sparkfun/SparkFun_IoT_RedBoard-ESP32-P4/docs/docs/Resources.md

# Resources

For more information about the SparkFun IoT RedBoard ESP32-P4's, take a look at the following resources:

* [Datasheet](/ref/esp32-p4_datasheet_en.pdf) (ESP32-P4)
* [GitHub Repository](https://github.com/sparkfun/SparkFun_IoT_RedBoard-ESP32-P4)

**SparkFun IoT RedBoard ESP32-P4 & ESP32-C5 (WiFi/BLE)**

* [Schematic](/ref/SparkFun_IoT_RedBoard-ESP32-P4_WiFi_BLE.pdf)
* [KiCad Files](/ref/SparkFun_IoT_RedBoard-ESP32-P4_WiFi_BLE.zip)
* [Datasheet](/ref/esp32-c5-wroom-1_wroom-1u_datasheet_en.pdf) (ESP32-C5 WROOM)

**SparkFun IoT RedBoard ESP32-P4 - PoE**

* [Schematic](/ref/SparkFun_IoT_RedBoard-ESP32-P4_PoE.pdf)
* [KiCad Files](/ref/SparkFun_IoT_RedBoard-ESP32-P4_PoE.zip)
