sparkfun/SparkFun_IoT_RedBoard-ESP32-P4/Hardware/PoE/Production/ordering_instructions.txt

Ordering Instructions:
Panel dimensions: 389.58 x 131.24 mm.
Controlled Impedance: JLC04161H-7628
Material: TG135
Solder Mask: Red
Silkscreen Color: White
Layers: 4
Finish: Lead-Free HASL
Thickness: 1.6mm
Outer Copper Weight: 1oz
Inner Copper Weight: 0.5oz
Minimum track width: 0.12mm (4.80mil)
Minimum via drill: 0.30mm (11.81mil)
No Clean Process
