sparkfun/SparkFun_IoT_RedBoard-ESP32-P4/docs/static/ref/SparkFun_IoT_RedBoard-ESP32-P4_PoE.pdf

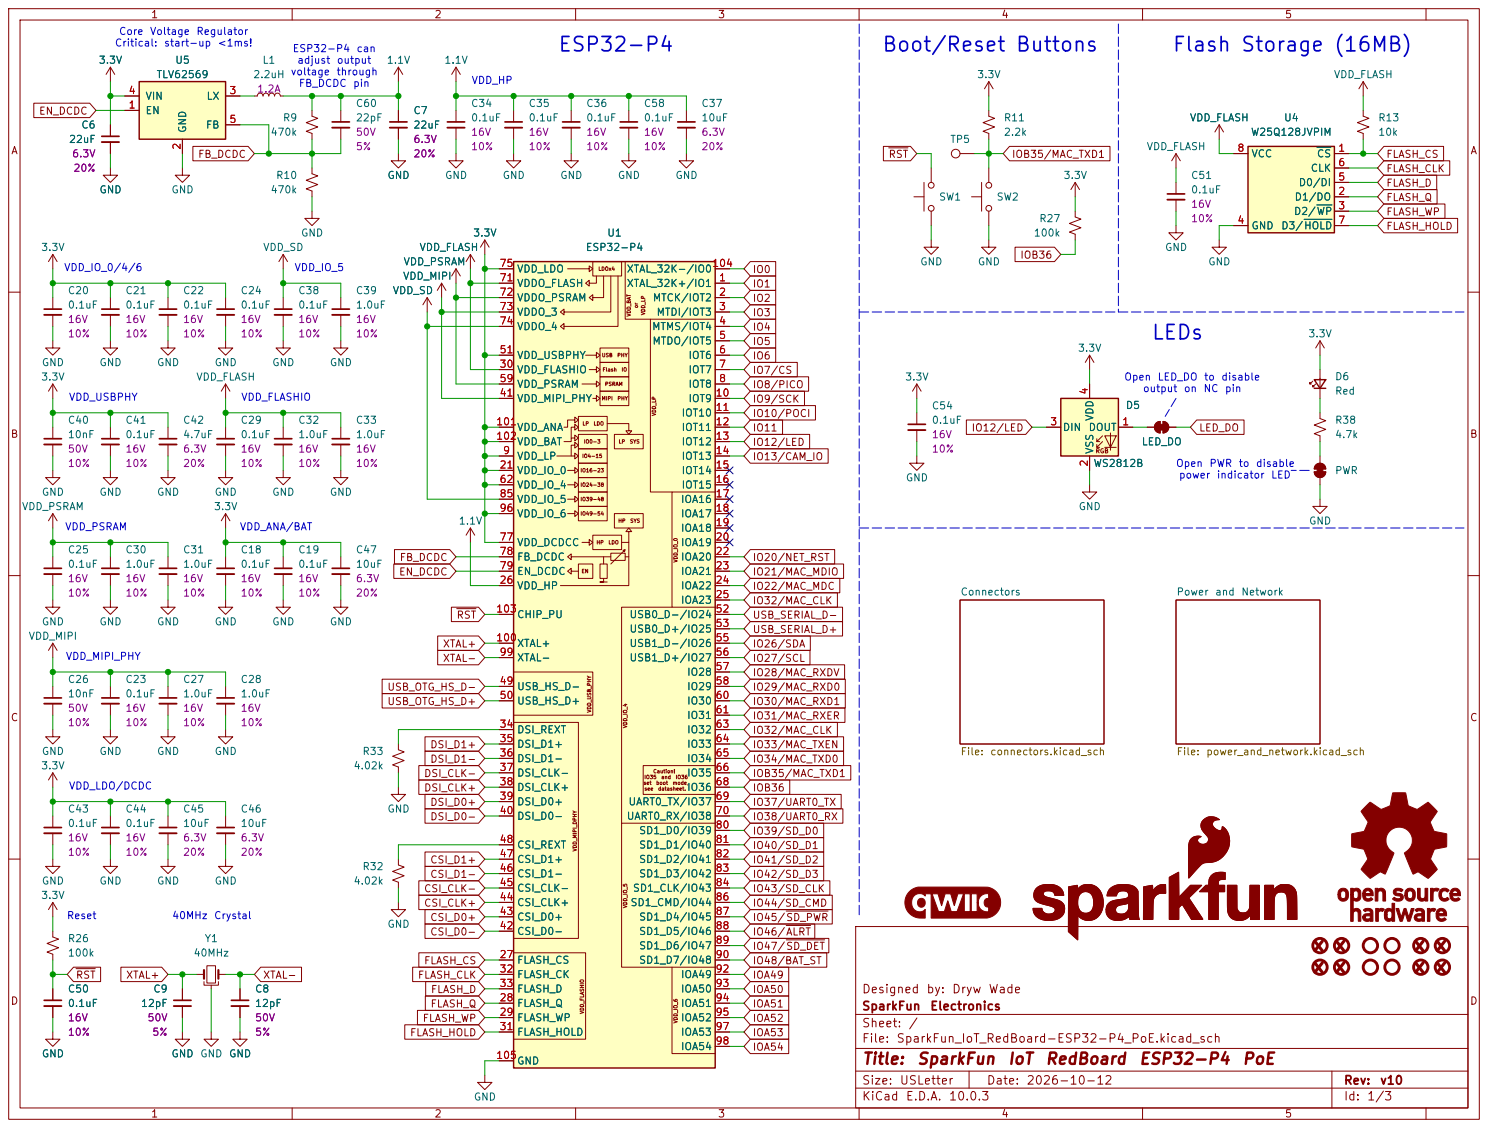
[picture p3: page 1]

Core Voltage Regulator Critical: start-up <1ms! VDD_USBPHY
TLV62569 GND

VDD_LDO 75 | XTAL_32K-/IO0104

VDDO_PSRAM 72

VDDO_4 74

Open LED_DO to disable output on NC pin

Open PWR to disable power indicator LED

Caution! IO35 and | IO35 66 IO35 66 IO36 IO36 68 UART0_TX/IO37 69 UART0_RX/IO38 70 IO36 68 UART0_TX/IO37 69 UART0_RX/IO38 70

Designed by: Dryw Wade
SparkFun Electronics
Sheet: /
File: SparkFun_IoT_RedBoard-ESP32-P4_PoE.kicad_sch
Title: SparkFun IoT RedBoard ESP32-P4 PoE

Size: USLetter | Rev: v10
KiCad E.D.A. 10.0.3 | Id: 1/3

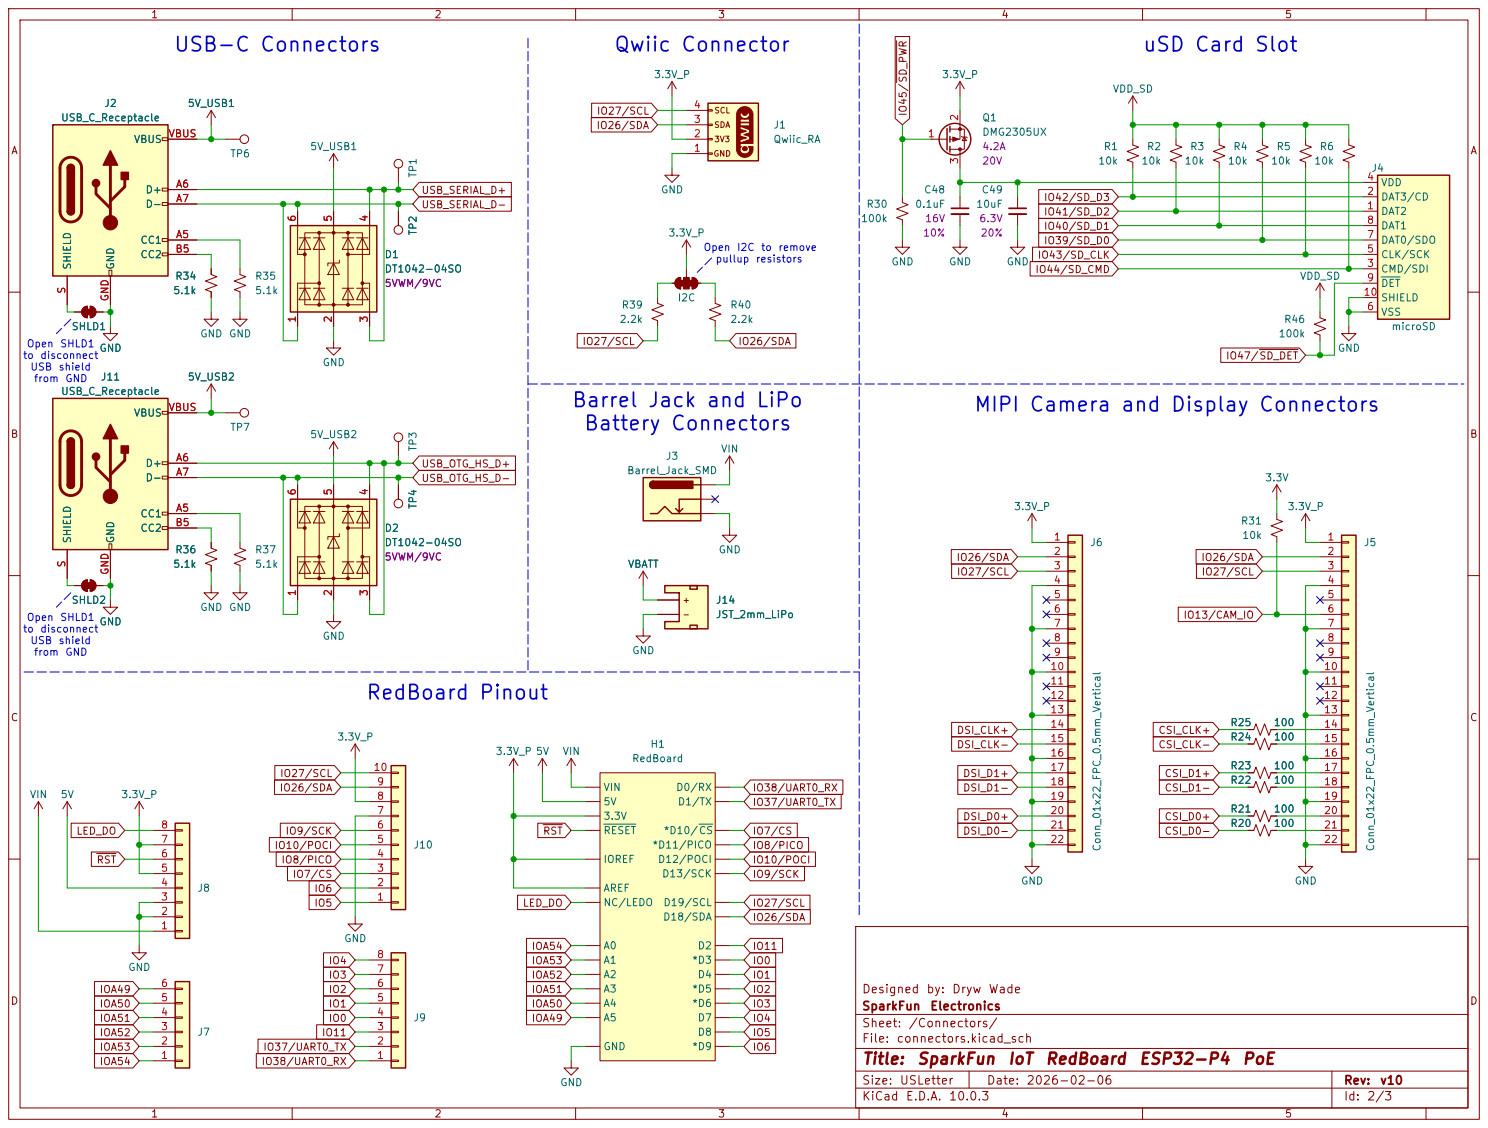
[picture p4: page 2]

VDD 4 CLK/SCK 5 VSS 6 DAT0/SDO 7 DAT1 8 DET 9

SHIELD 10

Open SHLD1
to disconnect USB shield

Barrel Jack and LiPo
Battery Connectors
VBATT VIN

IO0 Open SHLD1

Designed by: Dryw Wade
SparkFun Electronics
Sheet: /Connectors/
File: connectors.kicad_sch
Title: SparkFun IoT RedBoard ESP32-P4 PoE

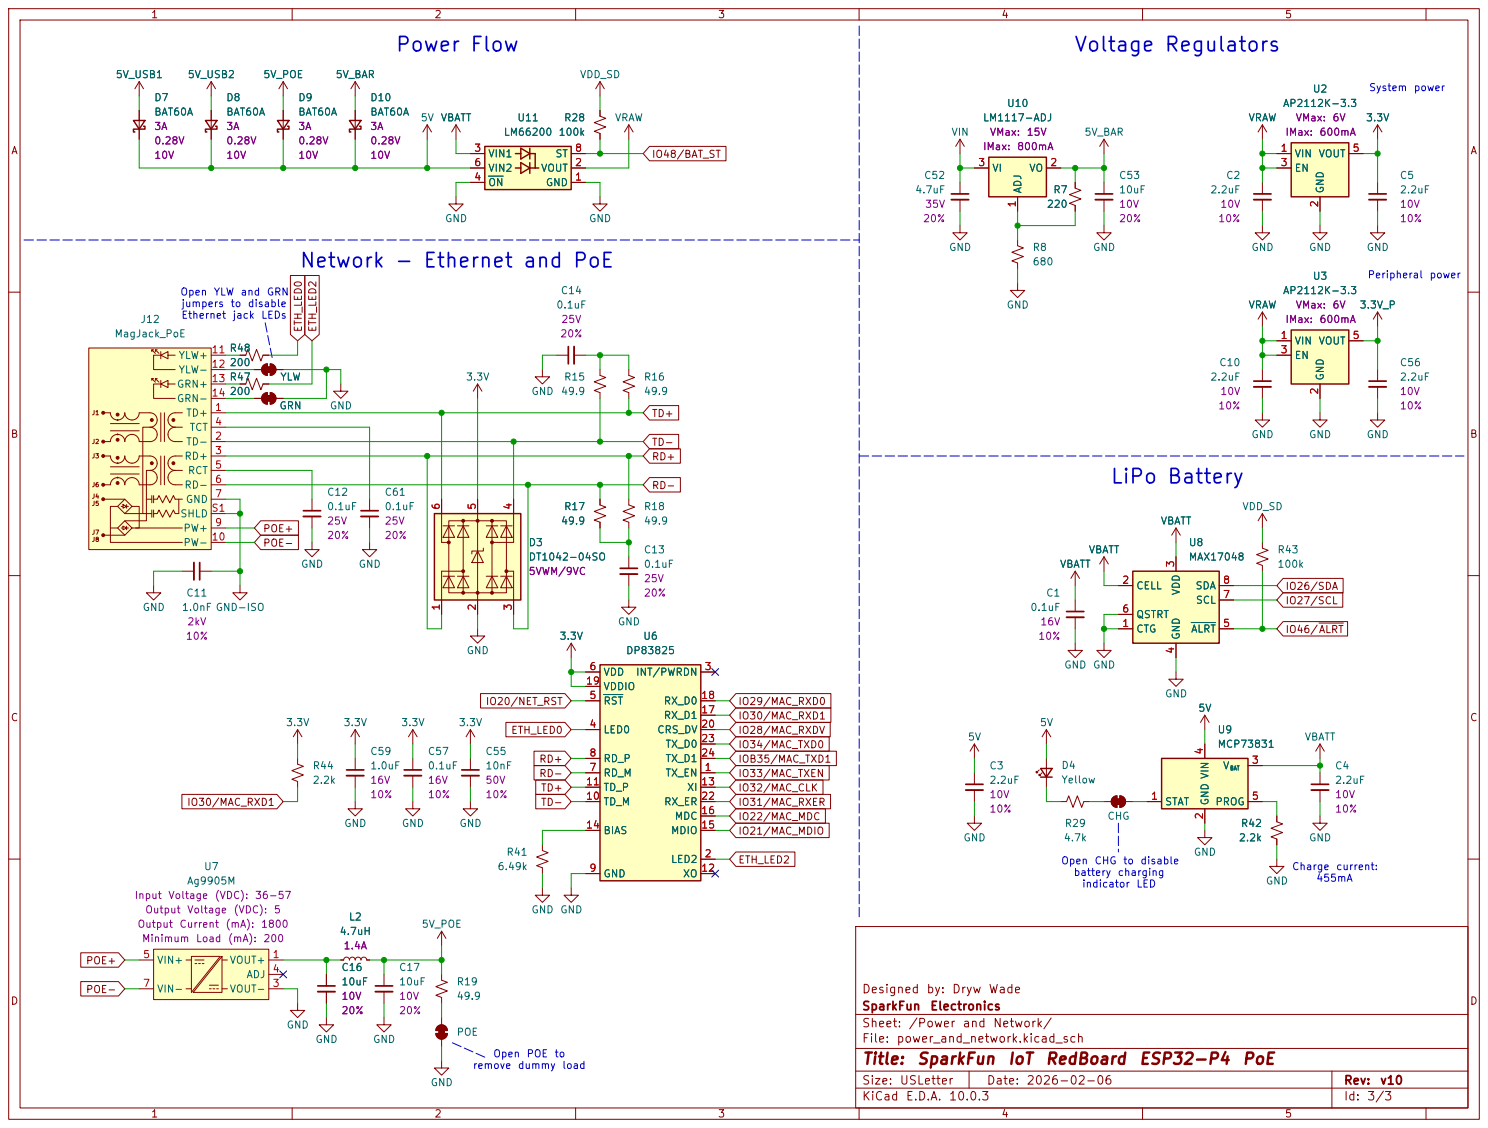
[picture p5: page 3]

indicator LED Voltage Regulators
LM1117-ADJ VMax: 15V
VIN
IMax: 800mA ADJ 1

Network - Ethernet and PoE

Peripheral power Open POE to

Open YLW and GRN

Designed by: Dryw Wade
SparkFun Electronics
Sheet: /Power and Network/
File: power_and_network.kicad_sch
Title: SparkFun IoT RedBoard ESP32-P4 PoE
