sparkfun/SparkFun_IoT_RedBoard-ESP32-P4/docs/static/ref/SparkFun_IoT_RedBoard-ESP32-P4_WiFi_BLE.pdf

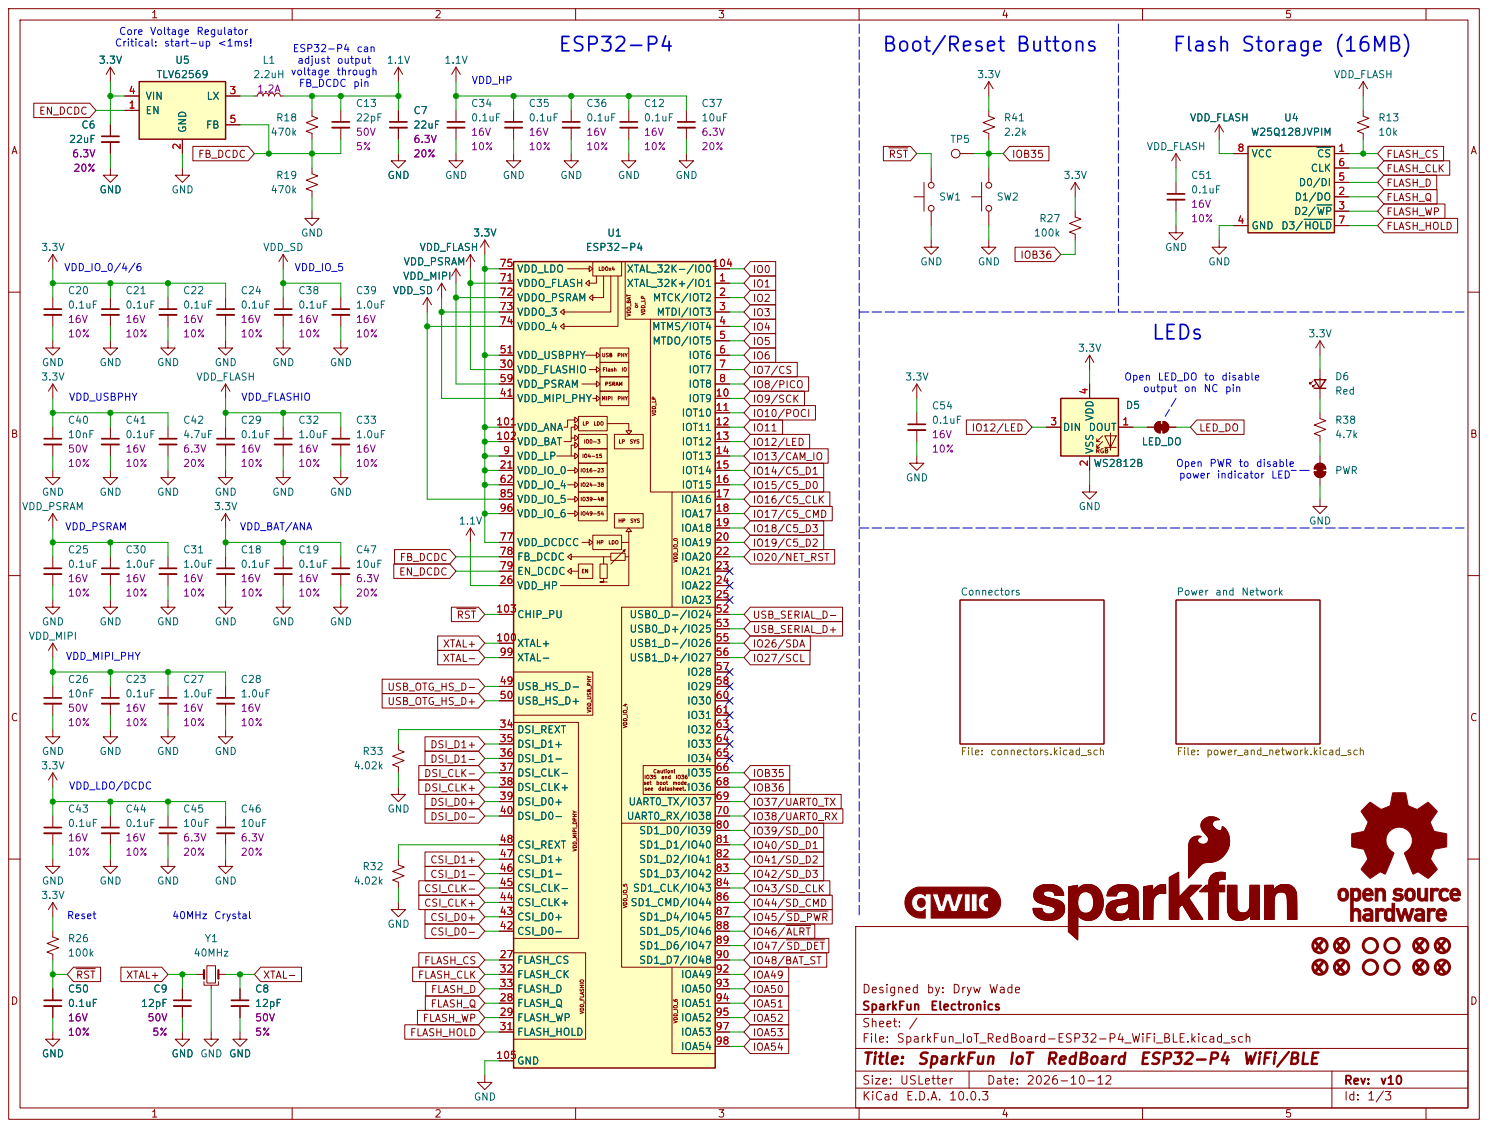
[picture p6: page 1]

VDD_LDO 75 | XTAL_32K-/IO0104

VDDO_PSRAM 72

VDDO_4 74

Open PWR to disable power indicator LED

Caution! IO35 and | IO35 66 IO35 66 IO36 IO36 68 UART0_TX/IO37 69 UART0_RX/IO38 70 IO36 68 UART0_TX/IO37 69 UART0_RX/IO38 70

Designed by: Dryw Wade
SparkFun Electronics
Sheet: /
File: SparkFun_IoT_RedBoard-ESP32-P4_WiFi_BLE.kicad_sch
Title: SparkFun IoT RedBoard ESP32-P4 WiFi/BLE

Size: USLetter | Rev: v10
KiCad E.D.A. 10.0.3 | Id: 1/3

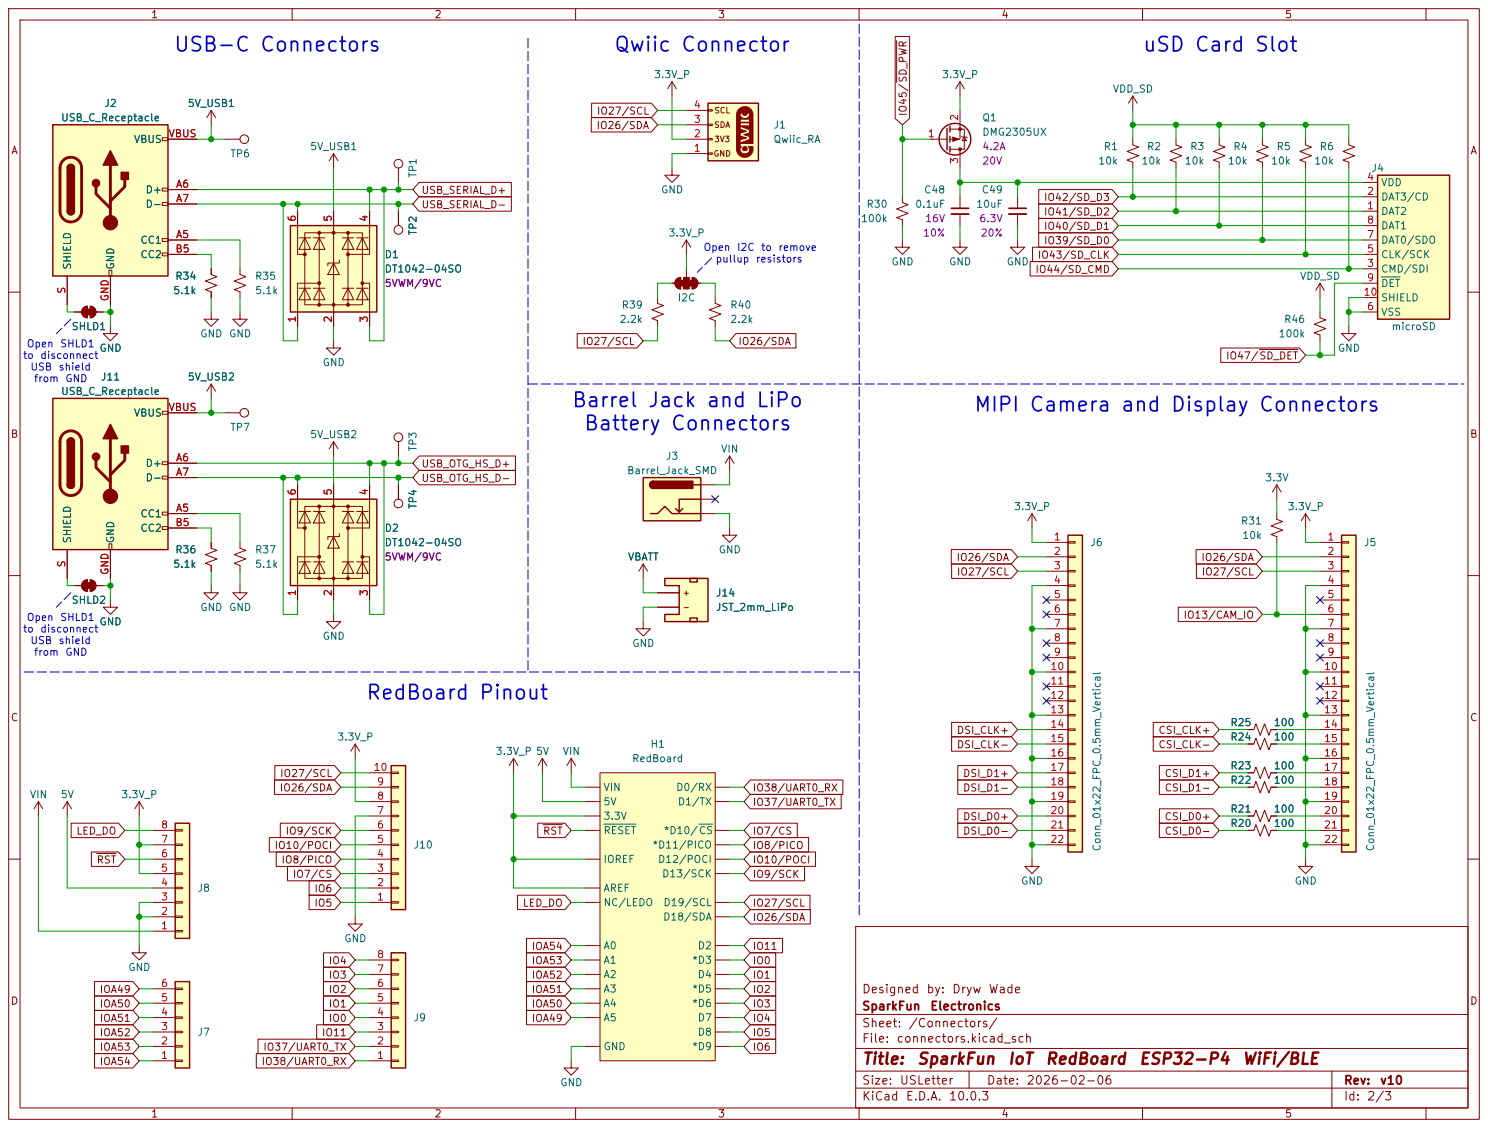
[picture p7: page 2]

VDD 4 CLK/SCK 5 DAT2 1 DAT3/CD 2 CMD/SDI 3 VSS 6 DAT0/SDO 7 DAT1 8 DET 9

Open I2C to remove pullup resistors VBATT

SHIELD 10

Open SHLD1
to disconnect USB shield

Barrel Jack and LiPo
Battery Connectors

Designed by: Dryw Wade
SparkFun Electronics
Sheet: /Connectors/
File: connectors.kicad_sch
Title: SparkFun IoT RedBoard ESP32-P4 WiFi/BLE

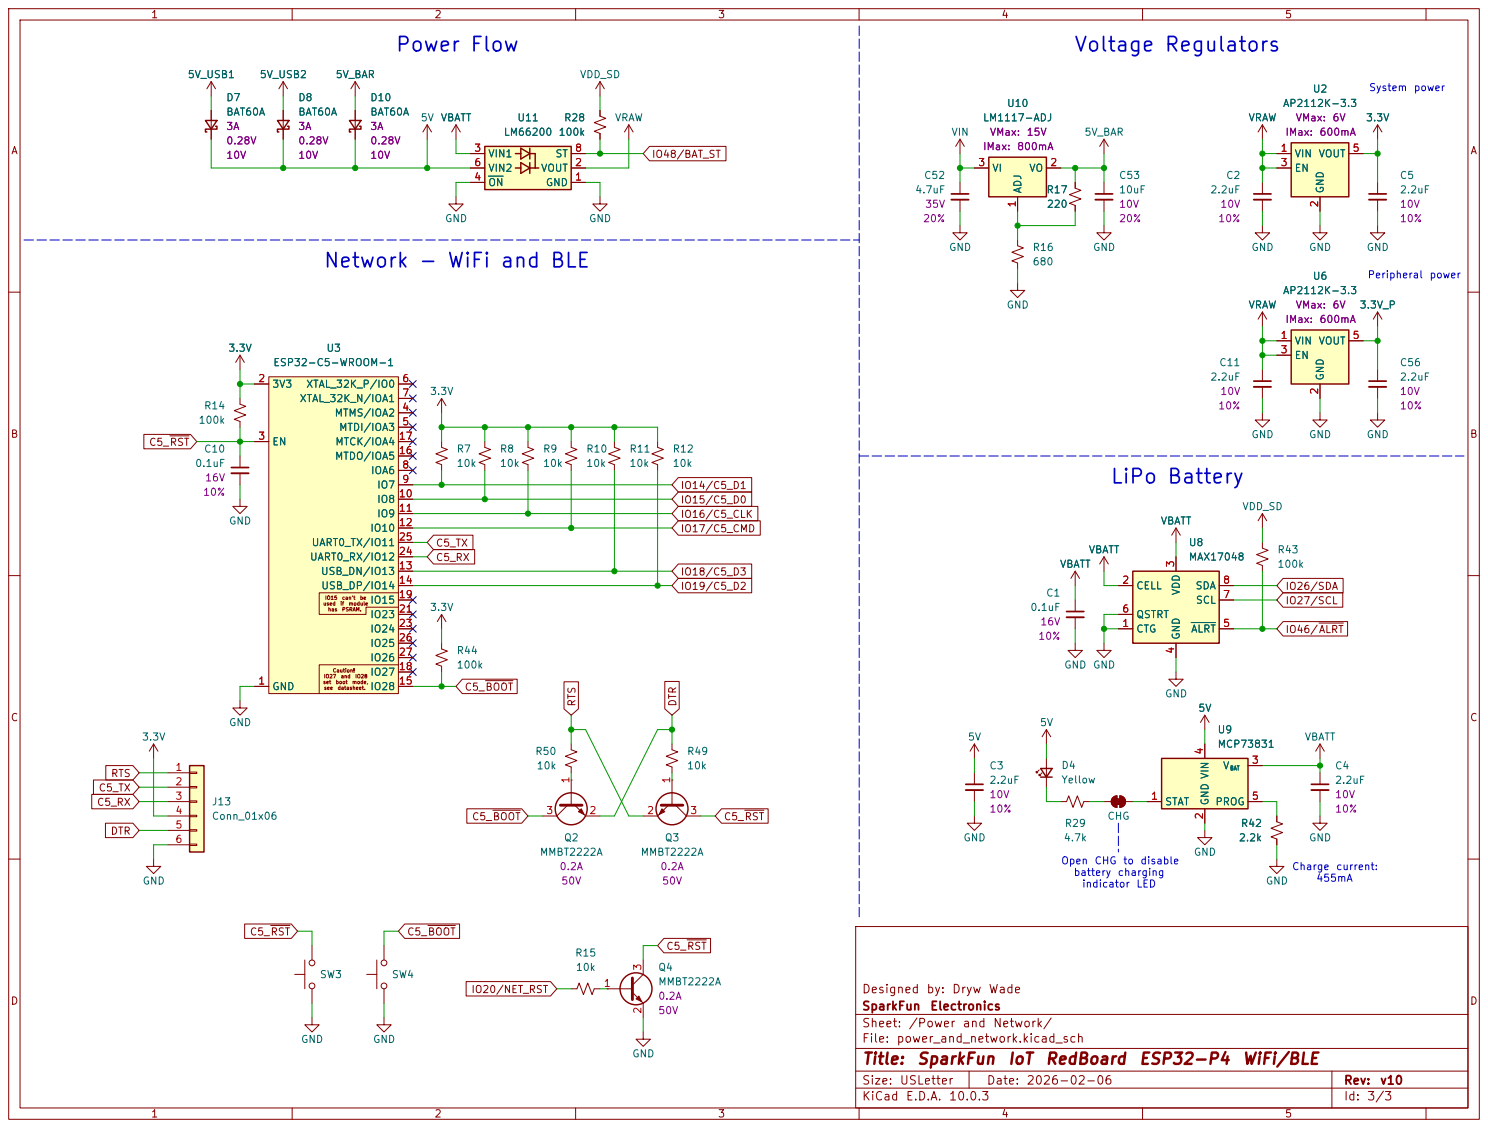
[picture p8: page 3]

Network - WiFi and BLE

IO15 can't be used if module has PSRAM. Caution!

Open CHG to disable battery charging

Designed by: Dryw Wade
SparkFun Electronics
Sheet: /Power and Network/
File: power_and_network.kicad_sch
Title: SparkFun IoT RedBoard ESP32-P4 WiFi/BLE
