sparkfun/SparkFun_IoT_RedBoard-ESP32-P4/(commit log)

2026-01-28 Add preliminary design
    Still very much in progress!
    [SparkFun_IoT_RedBoard-ESP32-P4.kicad_pcb, SparkFun_IoT_RedBoard-ESP32-P4.kicad_sch, connectors.kicad_sch, power_and_network.kicad_sch]
2026-02-04 Almost finished initial routing
    Need to put LEDs somewhere
    Need to improve high speed traces (differential pairs, spacing, etc).
    Need to do general cleanup (add vias, clean up junctions, etc.)
    Need to aplit design into 2 versions (1 for PoE, 1 for WiFi/BLE)
    [SparkFun_IoT_RedBoard-ESP32-P4.kicad_pcb, SparkFun_IoT_RedBoard-ESP32-P4.kicad_sch, connectors.kicad_sch, power_and_network.kicad_sch]
2026-02-05 Finish initial routing of ethernet board
    Also added GND zones in layer 3 for proper ground coupling for high-speed traces
    [SparkFun_IoT_RedBoard-ESP32-P4.kicad_pcb, SparkFun_IoT_RedBoard-ESP32-P4.kicad_sch, power_and_network.kicad_sch]
2026-02-05 Route proper differential pairs
    [SparkFun_IoT_RedBoard-ESP32-P4.kicad_pcb, SparkFun_IoT_RedBoard-ESP32-P4.kicad_sch, connectors.kicad_sch, power_and_network.kicad_sch]
2026-02-06 Tune MIPI differential pair skews
    Not enough space to length match all pairs. It's probably fine
    Also add GND vias near all GND pads
    [SparkFun_IoT_RedBoard-ESP32-P4.kicad_pcb]
2026-02-06 Finish initial PoE design
    [SparkFun_IoT_RedBoard-ESP32-P4.kicad_pcb, SparkFun_IoT_RedBoard-ESP32-P4.kicad_sch, connectors.kicad_sch, power_and_network.kicad_sch]
2026-02-06 Split design into wired and wireless folders
    [SparkFun_IoT_RedBoard-ESP32-P4_PoE.kicad_pcb, SparkFun_IoT_RedBoard-ESP32-P4_PoE.kicad_sch, SparkFun_IoT_RedBoard-ESP32-P4_WiFi_BLE.kicad_pcb, SparkFun_IoT_RedBoard-ESP32-P4_WiFi_BLE.kicad_sch, connectors.kicad_sch, power_and_network.kicad_sch]
2026-02-06 Remove wireless components from PoE design
    [SparkFun_IoT_RedBoard-ESP32-P4_PoE.kicad_pcb, SparkFun_IoT_RedBoard-ESP32-P4_PoE.kicad_sch, power_and_network.kicad_sch]
2026-02-06 Remove PoE components from wireless design
    Also position and route all wireless components
    [SparkFun_IoT_RedBoard-ESP32-P4_WiFi_BLE.kicad_pcb, SparkFun_IoT_RedBoard-ESP32-P4_WiFi_BLE.kicad_sch, power_and_network.kicad_sch]
2026-02-06 Add test points for USB and boot button
    [SparkFun_IoT_RedBoard-ESP32-P4_PoE.kicad_pcb, SparkFun_IoT_RedBoard-ESP32-P4_PoE.kicad_sch, SparkFun_IoT_RedBoard-ESP32-P4_WiFi_BLE.kicad_pcb, SparkFun_IoT_RedBoard-ESP32-P4_WiFi_BLE.kicad_sch, connectors.kicad_sch]
2026-02-06 Add test points for USB power too
    [SparkFun_IoT_RedBoard-ESP32-P4_PoE.kicad_pcb, SparkFun_IoT_RedBoard-ESP32-P4_WiFi_BLE.kicad_pcb, connectors.kicad_sch]
2026-02-12 Design review updates
    Both schematics:
    Tidy up
    Add "IOn" to all GPIO net names
    PoE schematic:
    Add jumpers for ethernet jack LEDs
    Add measure jumpers for PoE power
    Both boards:
    Increase power trace widths
    Increase logo and board name silk size on back
    Add "IOn" label to RGB LED
    PoE board:
    Increase milled slot tab size
    WiFi/BLE board:
    Increase logo and board name silk size on front
    [SparkFun_IoT_RedBoard-ESP32-P4_PoE.kicad_pcb, SparkFun_IoT_RedBoard-ESP32-P4_PoE.kicad_sch, SparkFun_IoT_RedBoard-ESP32-P4_WiFi_BLE.kicad_pcb, SparkFun_IoT_RedBoard-ESP32-P4_WiFi_BLE.kicad_sch, connectors.kicad_sch, power_and_network.kicad_sch]
2026-02-12 Add jumper text and board dimensions
    [SparkFun_IoT_RedBoard-ESP32-P4_PoE.kicad_pcb, SparkFun_IoT_RedBoard-ESP32-P4_PoE.kicad_sch, SparkFun_IoT_RedBoard-ESP32-P4_WiFi_BLE.kicad_pcb, SparkFun_IoT_RedBoard-ESP32-P4_WiFi_BLE.kicad_sch, connectors.kicad_sch, power_and_network.kicad_sch]
2026-02-12 Fix SD net name
    IO42 is D3, not D2!
    [SparkFun_IoT_RedBoard-ESP32-P4_PoE.kicad_pcb, SparkFun_IoT_RedBoard-ESP32-P4_PoE.kicad_sch, SparkFun_IoT_RedBoard-ESP32-P4_WiFi_BLE.kicad_pcb, SparkFun_IoT_RedBoard-ESP32-P4_WiFi_BLE.kicad_sch, connectors.kicad_sch]
2026-02-12 Add MOSFET for C5 reset on wireless board
    [SparkFun_IoT_RedBoard-ESP32-P4_WiFi_BLE.kicad_pcb, power_and_network.kicad_sch]
2026-02-12 Adjsut fiducials
    Move existing fiducials to opposite corners
    Add local fiducials for USB-C connectors
    [SparkFun_IoT_RedBoard-ESP32-P4_PoE.kicad_pcb, SparkFun_IoT_RedBoard-ESP32-P4_PoE.kicad_sch, SparkFun_IoT_RedBoard-ESP32-P4_WiFi_BLE.kicad_pcb, SparkFun_IoT_RedBoard-ESP32-P4_WiFi_BLE.kicad_sch]
2026-02-12 Add second 3.3V regulator for peripherals
    Total board current is likely to be >600mA when external devices are connected
    [SparkFun_IoT_RedBoard-ESP32-P4_PoE.kicad_pcb, SparkFun_IoT_RedBoard-ESP32-P4_WiFi_BLE.kicad_pcb, connectors.kicad_sch, power_and_network.kicad_sch]
2026-02-12 Remove POE current measurement jumpers
    Would have cause issues with selective solder
    [SparkFun_IoT_RedBoard-ESP32-P4_PoE.kicad_pcb, power_and_network.kicad_sch]
2026-02-12 Also remove silk labels
    [SparkFun_IoT_RedBoard-ESP32-P4_PoE.kicad_pcb]
2026-02-12 Rotate serial header on wireless board
    If using a serial breakout, should avoid interference with the buttons
    [SparkFun_IoT_RedBoard-ESP32-P4_WiFi_BLE.kicad_pcb]
2026-02-12 dd center positive marker for barrel connector
    [SparkFun_IoT_RedBoard-ESP32-P4_PoE.kicad_pcb, SparkFun_IoT_RedBoard-ESP32-P4_WiFi_BLE.kicad_pcb]
2026-02-13 Swap LEDs for 0603 and LM1117 for adjustable version
    Don't have 0402 yellow LED, nor fixed 5V LM1117 in stock
    [SparkFun_IoT_RedBoard-ESP32-P4_PoE.kicad_pcb, SparkFun_IoT_RedBoard-ESP32-P4_PoE.kicad_sch, SparkFun_IoT_RedBoard-ESP32-P4_WiFi_BLE.kicad_pcb, SparkFun_IoT_RedBoard-ESP32-P4_WiFi_BLE.kicad_sch, power_and_network.kicad_sch]
2026-02-13 Add PROD_ID for ESP32-P4
    [SparkFun_IoT_RedBoard-ESP32-P4_PoE.kicad_pcb, SparkFun_IoT_RedBoard-ESP32-P4_PoE.kicad_sch, SparkFun_IoT_RedBoard-ESP32-P4_WiFi_BLE.kicad_pcb, SparkFun_IoT_RedBoard-ESP32-P4_WiFi_BLE.kicad_sch]
2026-02-13 Swap N-channel FETs
    Don't have dual package in stock, swapping to single package
    Also fix PROD_ID of single FET package
    [SparkFun_IoT_RedBoard-ESP32-P4_WiFi_BLE.kicad_pcb, power_and_network.kicad_sch]
2026-04-10 Bump version number to v10
    [SparkFun_IoT_RedBoard-ESP32-P4_PoE.kicad_pcb, SparkFun_IoT_RedBoard-ESP32-P4_PoE.kicad_sch, SparkFun_IoT_RedBoard-ESP32-P4_WiFi_BLE.kicad_pcb, SparkFun_IoT_RedBoard-ESP32-P4_WiFi_BLE.kicad_sch, connectors.kicad_sch, power_and_network.kicad_sch]
2026-04-10 Update pin 54 of ESP32-P4, add 0.1uF capacitor
    Chip revision 3.x changes pin 54 to a power pin...
    [SparkFun_IoT_RedBoard-ESP32-P4_PoE.kicad_pcb, SparkFun_IoT_RedBoard-ESP32-P4_PoE.kicad_sch, SparkFun_IoT_RedBoard-ESP32-P4_WiFi_BLE.kicad_pcb, SparkFun_IoT_RedBoard-ESP32-P4_WiFi_BLE.kicad_sch]
2026-04-10 Add feedback resistors and capacitor to DCDC regulator
    Chip revision 3.x changes requires this now...
    Squeezing this in was a challenge, my head hurts...
    [SparkFun_IoT_RedBoard-ESP32-P4_PoE.kicad_pcb, SparkFun_IoT_RedBoard-ESP32-P4_WiFi_BLE.kicad_pcb]
2026-04-10 Add external pullup to BOOT pin
    Ethernet PHY has internal pulldown, need to overcome that
    Also just good to have, since internal pullup is disabled after boot
    [SparkFun_IoT_RedBoard-ESP32-P4_PoE.kicad_pcb, SparkFun_IoT_RedBoard-ESP32-P4_PoE.kicad_sch, SparkFun_IoT_RedBoard-ESP32-P4_WiFi_BLE.kicad_pcb, SparkFun_IoT_RedBoard-ESP32-P4_WiFi_BLE.kicad_sch]
2026-04-10 PoE board - disconnect MagJack center taps
    The DP83825 doesn't like that! Need to keep them isolated
    with small capacitors on each
    [SparkFun_IoT_RedBoard-ESP32-P4_PoE.kicad_pcb, power_and_network.kicad_sch]
2026-04-13 Remove PHY strapping resistor from LED2
    Only needed for RMII Repeater Mode, which we are not using
    FWIW the RXD1 strapping resistor is needed, since clock comes from MAC
    [SparkFun_IoT_RedBoard-ESP32-P4_PoE.kicad_pcb, power_and_network.kicad_sch]
2026-04-13 Remove electrolytic capacitor from PoE
    It gets in the way of a user trying to use the DSI connector
    Testing has shown almost zero difference in behavior with this capacitor removed
    [SparkFun_IoT_RedBoard-ESP32-P4_PoE.kicad_pcb, power_and_network.kicad_sch]
2026-04-13 Update WiFi boot/reset circuitry
    Swap MOSFETs for BJTs - body diode was causing problems
    Change pull up/down resistors to instead be inline with base pins
    Add pullup to boot net, now that it's not automatically pulled up through body diode
    Move buttons left of header so right-angle headers can be soldered
    Move SparkFun logo out of the way
    [SparkFun_IoT_RedBoard-ESP32-P4_WiFi_BLE.kicad_pcb, power_and_network.kicad_sch]
2026-04-13 Add big SparkFun logo to wired board to match wireless board
    [SparkFun_IoT_RedBoard-ESP32-P4_PoE.kicad_pcb]
2026-04-22 Wireless board - Set MAC pins to NC flags
    Also rename Pin 35 to BOOT
    [SparkFun_IoT_RedBoard-ESP32-P4_WiFi_BLE.kicad_pcb, SparkFun_IoT_RedBoard-ESP32-P4_WiFi_BLE.kicad_sch]
2026-04-22 Wired board - combine MAC_CLK nets into single net
    [SparkFun_IoT_RedBoard-ESP32-P4_PoE.kicad_pcb, SparkFun_IoT_RedBoard-ESP32-P4_PoE.kicad_sch, power_and_network.kicad_sch]
2026-04-22 Improve 7-15V silk visibility
    Add text to bottom
    Slightly bigger text on top more centered on empty space
    [SparkFun_IoT_RedBoard-ESP32-P4_PoE.kicad_pcb, SparkFun_IoT_RedBoard-ESP32-P4_WiFi_BLE.kicad_pcb]
2026-04-22 Add helper text to schematics
    [SparkFun_IoT_RedBoard-ESP32-P4_PoE.kicad_pcb, SparkFun_IoT_RedBoard-ESP32-P4_WiFi_BLE.kicad_pcb, power_and_network.kicad_sch]
2026-04-22 Increase width of SHLD trace for lower impedance
    [SparkFun_IoT_RedBoard-ESP32-P4_PoE.kicad_pcb, SparkFun_IoT_RedBoard-ESP32-P4_WiFi_BLE.kicad_pcb]
2026-04-22 Increase silk line width
    [SparkFun_IoT_RedBoard-ESP32-P4_PoE.kicad_pcb, SparkFun_IoT_RedBoard-ESP32-P4_WiFi_BLE.kicad_pcb]
2026-04-22 Fix thermal spoke DRC errors
    [SparkFun_IoT_RedBoard-ESP32-P4_PoE.kicad_pcb, SparkFun_IoT_RedBoard-ESP32-P4_WiFi_BLE.kicad_pcb]
2026-04-22 Update board names in silk
    Also add RedBoard logo
    [SparkFun_IoT_RedBoard-ESP32-P4_PoE.kicad_pcb, SparkFun_IoT_RedBoard-ESP32-P4_WiFi_BLE.kicad_pcb]
2026-04-22 Increase power trace widths
    Also make Qwiic pull up to 3.3V_P
    [SparkFun_IoT_RedBoard-ESP32-P4_PoE.kicad_pcb, SparkFun_IoT_RedBoard-ESP32-P4_WiFi_BLE.kicad_pcb, connectors.kicad_sch]
2026-04-22 Add 3D model to L1
    [SparkFun_IoT_RedBoard-ESP32-P4_PoE.kicad_pcb, SparkFun_IoT_RedBoard-ESP32-P4_WiFi_BLE.kicad_pcb]
2026-04-22 Clean up GND zone for SDIO signals
    [SparkFun_IoT_RedBoard-ESP32-P4_PoE.kicad_pcb, SparkFun_IoT_RedBoard-ESP32-P4_WiFi_BLE.kicad_pcb]
2026-04-22 Rename BOOT IO pins to IOBn
    [SparkFun_IoT_RedBoard-ESP32-P4_PoE.kicad_pcb, SparkFun_IoT_RedBoard-ESP32-P4_PoE.kicad_sch, SparkFun_IoT_RedBoard-ESP32-P4_WiFi_BLE.kicad_pcb, SparkFun_IoT_RedBoard-ESP32-P4_WiFi_BLE.kicad_sch, power_and_network.kicad_sch]
2026-04-22 Update ESP32-P4 symbol
    Power pins now have clear diagrams
    Some power pins have been combined
    [SparkFun_IoT_RedBoard-ESP32-P4_PoE.kicad_pcb, SparkFun_IoT_RedBoard-ESP32-P4_PoE.kicad_sch, SparkFun_IoT_RedBoard-ESP32-P4_WiFi_BLE.kicad_pcb, SparkFun_IoT_RedBoard-ESP32-P4_WiFi_BLE.kicad_sch]
2026-04-23 Add v10 panels
    [SparkFun_IoT_RedBoard-ESP32-P4_PoE_panelized.GBL, SparkFun_IoT_RedBoard-ESP32-P4_PoE_panelized.GBO, SparkFun_IoT_RedBoard-ESP32-P4_PoE_panelized.GBP, SparkFun_IoT_RedBoard-ESP32-P4_PoE_panelized.GBS, SparkFun_IoT_RedBoard-ESP32-P4_PoE_panelized.GKO, SparkFun_IoT_RedBoard-ESP32-P4_PoE_panelized.GTL, SparkFun_IoT_RedBoard-ESP32-P4_PoE_panelized.GTO, SparkFun_IoT_RedBoard-ESP32-P4_PoE_panelized.GTP]
2026-10-12 Production updates
    Swap AP3429 for TLV62569 (need <1ms start up time)
    Add note about buck start up time to schematic
    Fix title in wireless schematic and board
    Update issue dates
    Library update
    [SparkFun_IoT_RedBoard-ESP32-P4_PoE.kicad_pcb, SparkFun_IoT_RedBoard-ESP32-P4_PoE.kicad_sch, SparkFun_IoT_RedBoard-ESP32-P4_WiFi_BLE.kicad_pcb, SparkFun_IoT_RedBoard-ESP32-P4_WiFi_BLE.kicad_sch, connectors.kicad_sch, power_and_network.kicad_sch]
2026-10-30 Add Arduino board support with ESP32-C5 drop-in
    Board variants for the WiFi/BLE and PoE RedBoard ESP32-P4, hardware
    tests, and a 5-file drop-in for the stock arduino-esp32 3.3.12 ESP32-P4
    libraries that builds ESP-Hosted for an ESP32-C5 co-processor instead of
    the C6. install.sh / install.ps1 install the board files and drop-in into
    a 3.3.12 core; build/ holds the inputs to rebuild it.
2026-10-30 Add PoE Ethernet test and apply the ETH patch in the install scripts
    RedBoardP4_PoE_Test checks the DP83825I link, DHCP, pings the gateway and
    sparkfun.com, and opens a TCP connection to sparkfun.com:443; run_tests.py
    gains --board poe to drive it. install.sh / install.ps1 now apply the
    RMII clock loopback patch by copying the pre-patched ETH.h/ETH.cpp from
    drop-in/Ethernet, backing up the stock files and restoring them on
    uninstall.
2026-10-30 Add serial menus to the test sketches and board tests to the PoE sketch
    Both sketches now take single-key commands in any case, ignore line
    endings so they work from the Arduino IDE Serial Monitor, and print a
    menu at boot and on '?'. The PoE sketch runs the same board tests as the
    WiFi/BLE sketch (defaults, pullups, I2C/fuel gauge, ADC, SD, RGB, BOOT)
    before Ethernet, since GPIO35 is also RMII TXD1. run_tests.py accepts a
    SKIP for the BOOT button test.
    [RedBoardP4_PoE_Test.ino, RedBoardP4_WiFi_Test.ino, run_tests.py]
2026-11-02 Add manual workflow to package Arduino folder as artifact
